ChirnoTech/RemPlug/README.md

RemPlug
==========
Esp8266 based Wi-fi smart plug

Specs:
- Input Voltage: 100-250V
- Current: 10A
- Wi-fi b/g/n
- MQTT, HTTP, etc controll

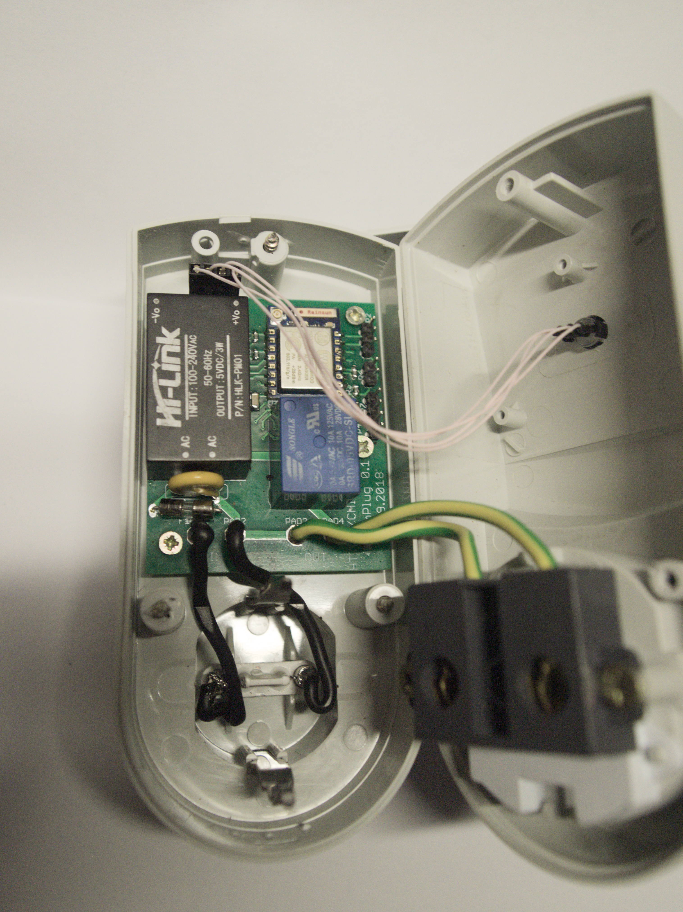
[picture p1: img/inside.jpg]
inside

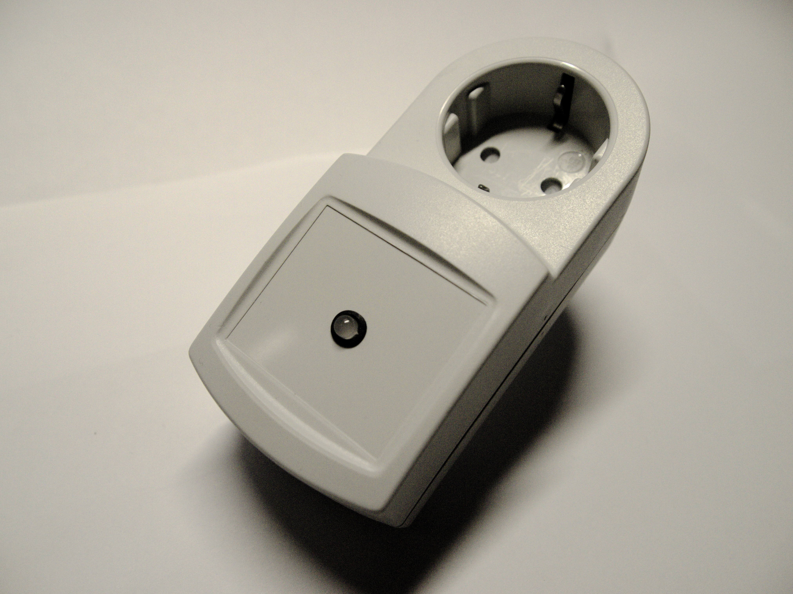
[picture p2: img/outside.jpg]
outside
