ChirnoTech/RemPlug/sch/mainSchema.brd

## EAGLE design sch/mainSchema.brd (2018-10-20)

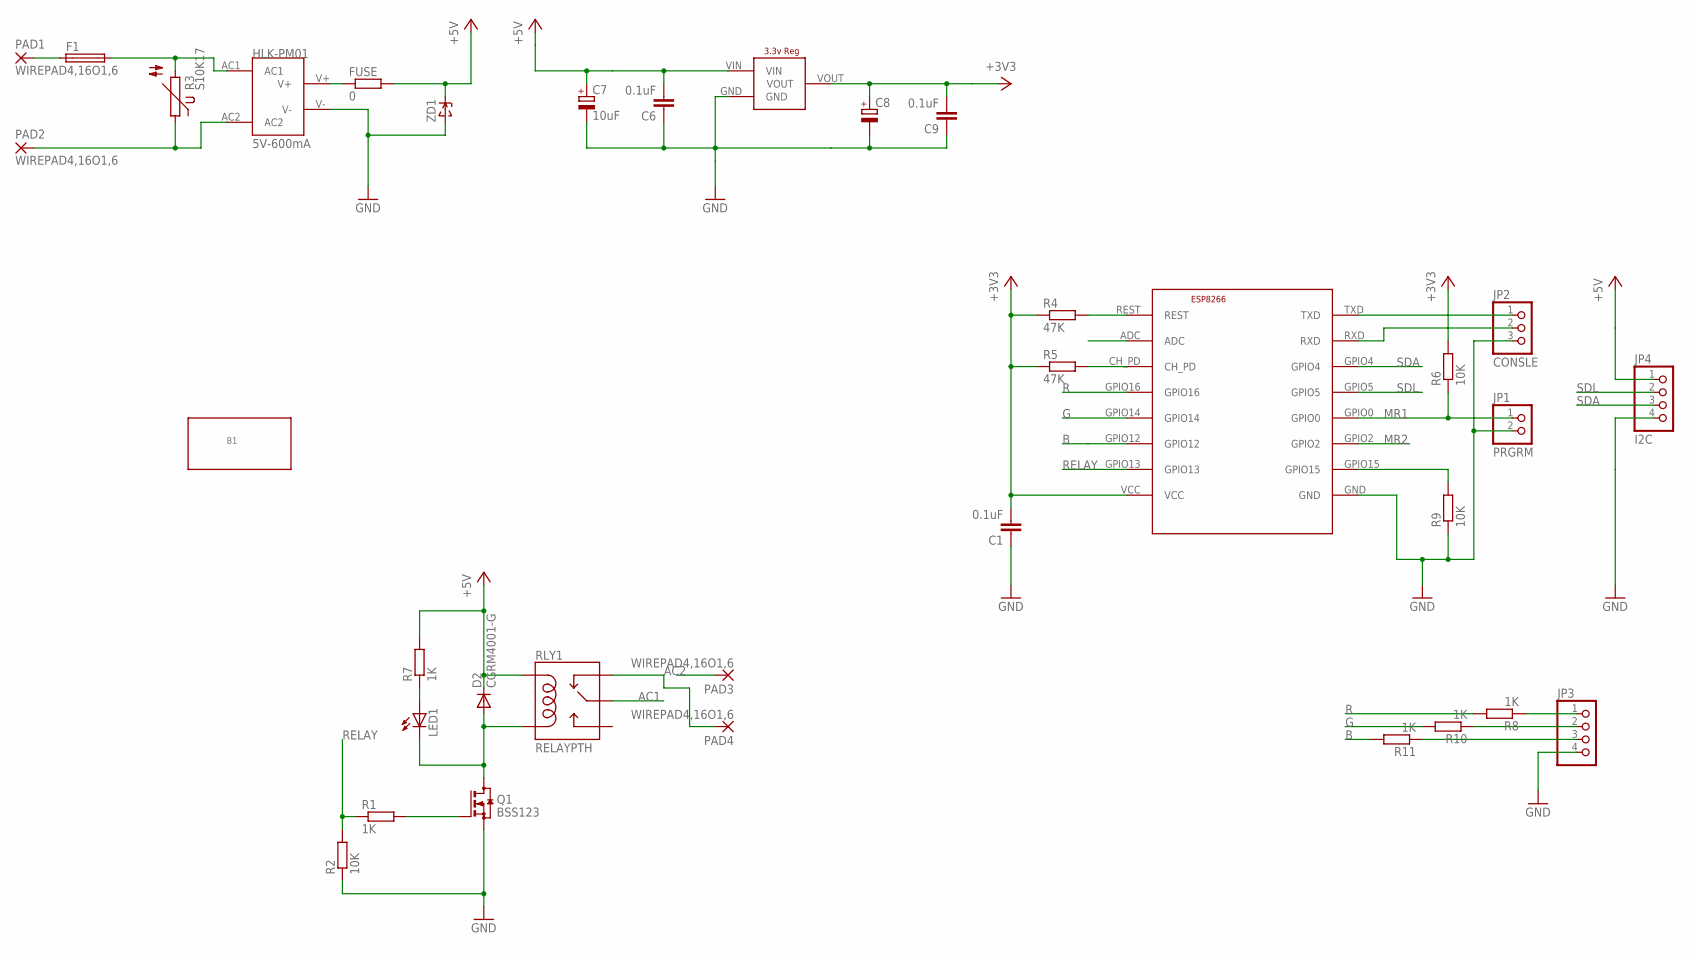
[picture p3: schematic mainSchema.sch]

Parts:
B1: VR1_POWER; VR1-POWER
C1, C6, C9: 0.1uF; C1206
C7: 10uF; PANASONIC_A
C8: CPOL-EUA; PANASONIC_A
D2: CGRM4001-G; SOD-123_MINI-SMA
ESP8266: ESP8266-07; ESP-07
F1: PICOFUSE
FUSE: 0; R1206
JP1: PRGRM; 1X02
JP2: CONSLE; 1X03
JP3: PINHD-1X4; 1X04
JP4: I2C; 1X04
LED1: LEDSMT1206; 1206
PAD1, PAD2, PAD3, PAD4: WIREPAD4,16O1,6; 4,16O1,6
Q1: BSS123; SOT23
R1, R7, R8, R10, R11: 1K; R0603
R2, R6, R9: 10K; R0603
R3: S10K17
R4, R5: 47K; R0603
RLY1: RELAYPTH; SRD-05VDC-SL-C
U$1: HILINK; HLK-PM01
U$5: LD1117; LD1117SOT-223
ZD1: ZENERSOD-123; SOD-123

Connections:
+3V3: C1.2, C8.+, C9.2, ESP8266.VCC, R4.1, R5.1, R6.2, U$5.VOUT
+5V: C6.2, C7.+, D2.C, FUSE.2, JP4.1, R7.2, RLY1.COIL1, U$5.VIN, ZD1.C
AC1: F1.2, R3.2, RLY1.SWCOMMON, U$1.AC1
AC2: PAD2.1, PAD3.1, R3.1, U$1.AC2
ADC: ESP8266.ADC
B: ESP8266.GPIO12, R11.2
G: ESP8266.GPIO14, R10.2
GND: C1.1, C6.1, C7.-, C8.-, C9.1, ESP8266.GND, JP1.2, JP2.3, JP3.4, JP4.4, Q1.2 (S), R2.1, R9.1, U$1.V-, U$5.GND, ZD1.A
MR1: ESP8266.GPIO0, JP1.1, R6.1
MR2: ESP8266.GPIO2
unnamed: PAD4.1, RLY1.SWCLOSED (SWCLOSE)
unnamed: F1.1, PAD1.1
unnamed: ESP8266.CH_PD, R5.2
unnamed: ESP8266.GPIO15, R9.2
unnamed: ESP8266.TXD, JP2.1
unnamed: ESP8266.RXD, JP2.2
unnamed: ESP8266.REST, R4.2
unnamed: FUSE.1, U$1.V+
unnamed: Q1.1 (G), R1.2
unnamed: D2.A, LED1.C, Q1.3 (D), RLY1.COIL0
unnamed: JP3.3, R11.1
unnamed: JP3.2, R10.1
unnamed: LED1.A, R7.1
unnamed: JP3.1, R8.1
R: ESP8266.GPIO16, R8.2
RELAY: ESP8266.GPIO13, R1.1, R2.2
SDA: ESP8266.GPIO4, JP4.3
SDL: ESP8266.GPIO5, JP4.2

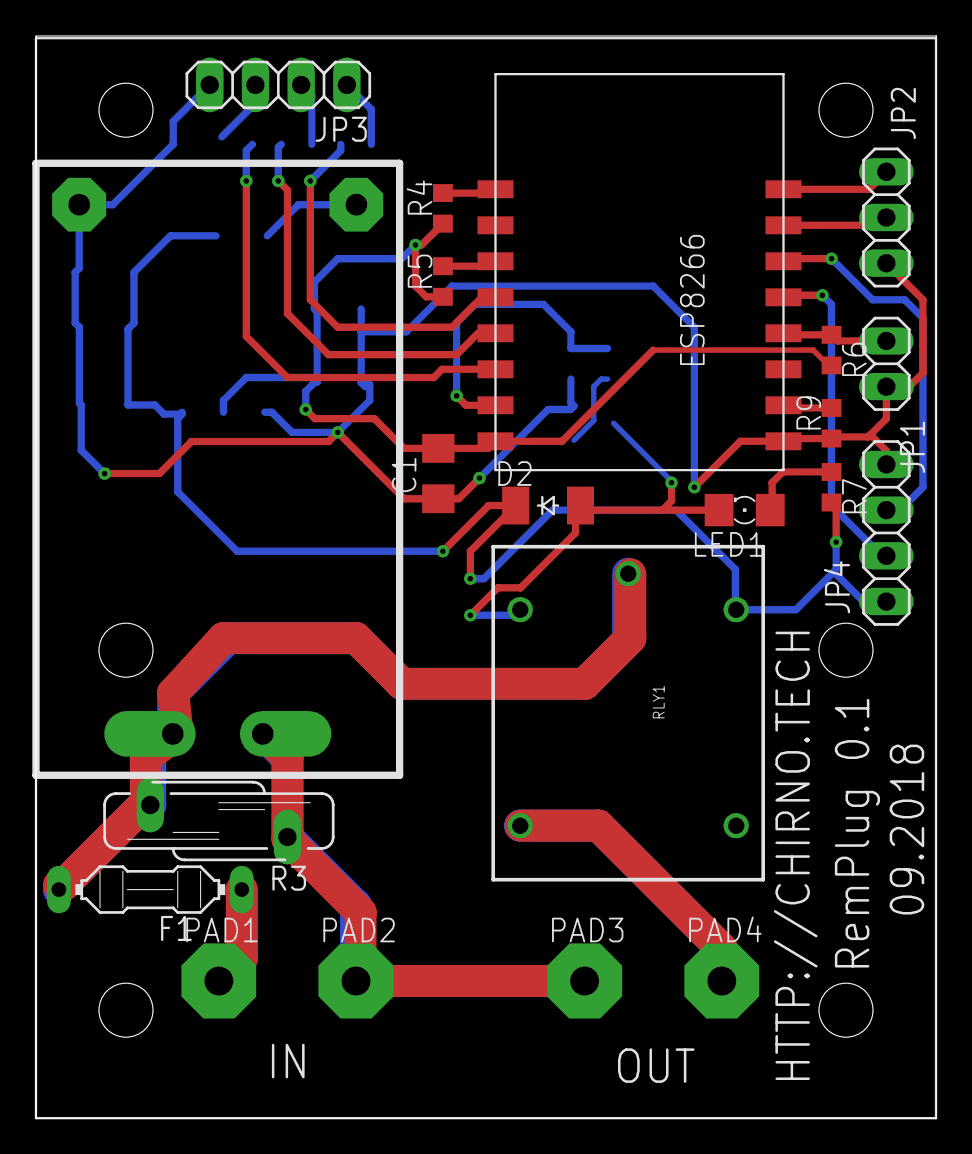
[picture p4: board mainSchema.brd from above]

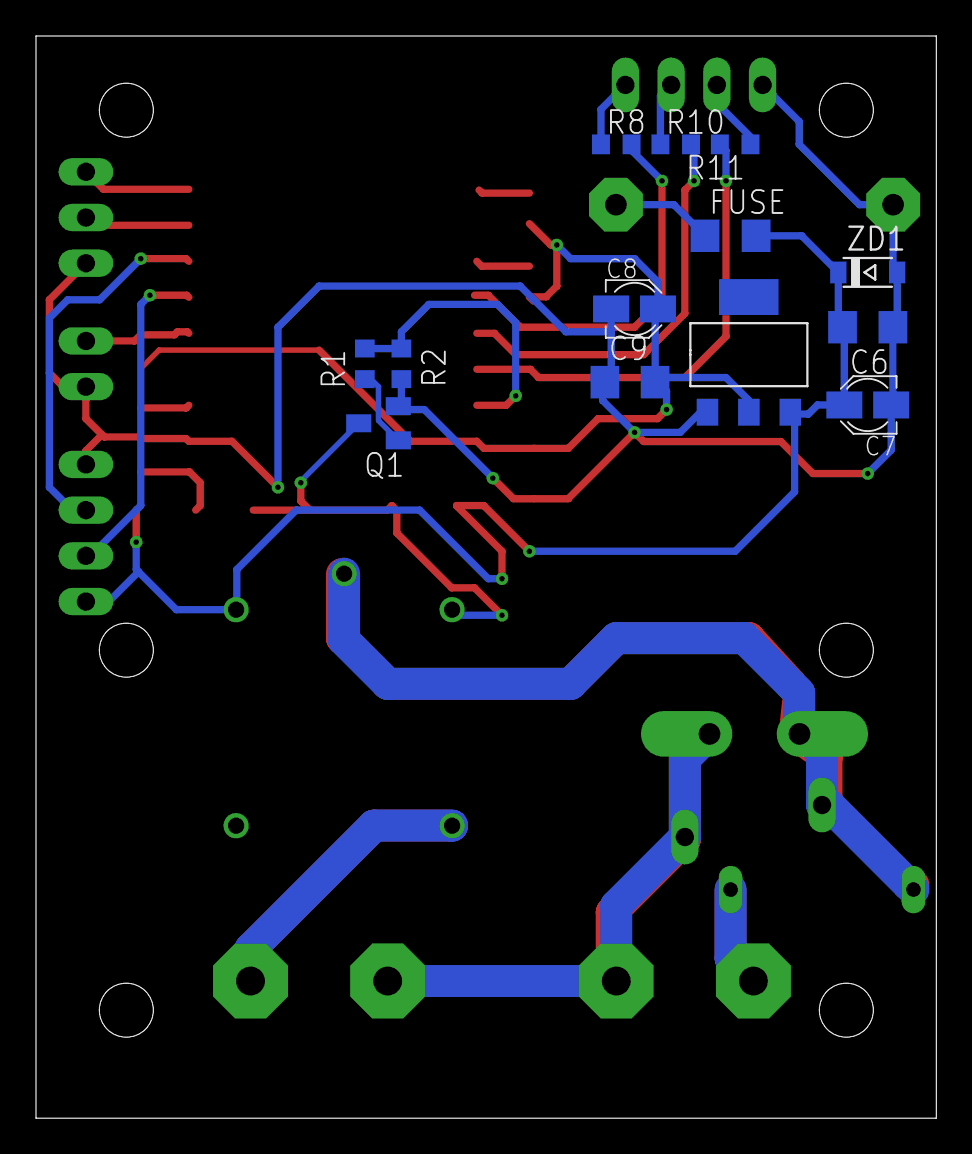
[picture p5: board mainSchema.brd from below]

Board: 2 copper layers, 50.0 x 60.1 mm, 35 parts (13 on the bottom side), 26 nets.
